makszimilien/Hydrofoil-Control/KiCad/Hydrofoil-Controller/Hydrofoil.kicad_pcb

## KiCad design KiCad/Hydrofoil-Controller/Hydrofoil.kicad_pcb (2024-01-26)

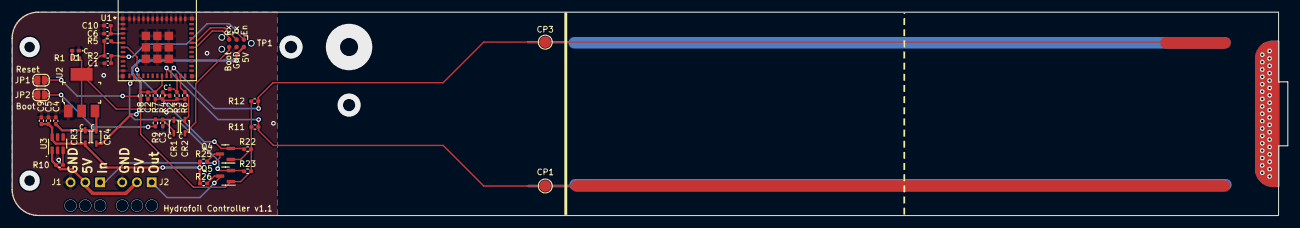
[picture p1: board Hydrofoil.kicad_pcb from above]

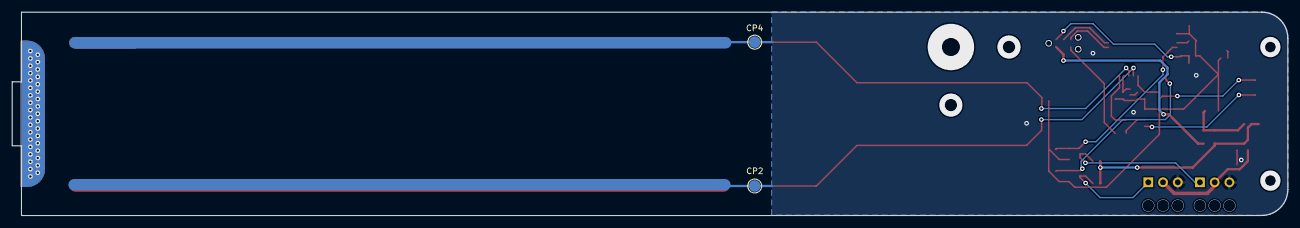
[picture p2: board Hydrofoil.kicad_pcb from below]

Board: 2 copper layers, 219.6 x 35.0 mm, 44 parts (2 on the bottom side), 26 nets.

Parts:
C1, C2, C3: 1u; C_0402_1005Metric_Pad0.74x0.62mm_HandSolder
C4, C5, C6, C9, C10: 10u; C_0402_1005Metric_Pad0.74x0.62mm_HandSolder
CP1, CP2: Long Probe; TestPoint_Pad_D2.0mm
CP3, CP4: Short Probe; TestPoint_Pad_D2.0mm
CR1, CR2, CR3, CR4: CUS08F30_H3F; USC_TOS
D1: Yellow; LED_0402_1005Metric_Pad0.77x0.64mm_HandSolder
D2: Red; LED_0402_1005Metric_Pad0.77x0.64mm_HandSolder
J1, J2: Conn_01x03_Pin; Solder_Connector
JP1: Reset Settings; SolderJumper-2_P1.3mm_Open_RoundedPad1.0x1.5mm
JP2: Boot; SolderJumper-2_P1.3mm_Open_RoundedPad1.0x1.5mm
Q4, Q5: BSS138; SOT-23
R1, R4, R8, R9: 1k; R_0402_1005Metric_Pad0.72x0.64mm_HandSolder
R2, R3, R5, R6, R7, R10, R22, R23, R25, R26: 10k; R_0402_1005Metric_Pad0.72x0.64mm_HandSolder
R11, R12: 1.4M; R_0402_1005Metric_Pad0.72x0.64mm_HandSolder
TP1: Tag-Connect_TC2030-IDC-NL_2x03_P1.27mm_Vertical
U1: ESP32-C3-MINI-1-N4; ESP32-C3-MINI-1_EXP
U2: LD1117S33CTR; SOT-223
U3: TPS22917DBV; SOT-23-6

Connections:
+3.3V: C6.1, C10.1, Q4.1 (G), Q5.1 (G), R1.1, R2.1, R3.1, R4.1, R5.1, R6.1, R7.1, R11.1, R12.1, R22.1, R23.1, U1.3 (3V3), U2.2 (VOUT), U2.4 (VOUT)
+5V: C5.1, C9.1, CR3.2, R25.1, R26.1, U3.6 (VOUT)
+5V-Prog: CR4.2, TP1.2
/+5V-Logic: C4.1, CR3.1, CR4.1, U2.3 (VIN)
/+5V-Raw: J1.2, J2.2, R10.2, U3.1 (VIN)
Cap-Long: CP1.1, R11.2, U1.20 (IO6)
Cap-Ref: CP3.1, R12.2, U1.21 (IO7)
ESP-Boot: CR2.1, TP1.6
ESP-En: C1.1, R2.2, TP1.1, U1.8 (EN)
ESP-Rx: TP1.5, U1.30 (RXD0)
ESP-Tx: TP1.3, U1.31 (TXD0)
GND: C1.2, C2.2, C3.2, C4.2, C5.2, C6.2, C9.2, C10.2, CP2.1, CP4.1, D1.1 (K), J1.3, J2.3, JP1.2 (B), JP2.2 (B), TP1.4, U1.1 (GND), U1.2 (GND), U1.11 (GND), U1.14 (GND), U1.36 (GND), U1.37 (GND), U1.38 (GND), U1.39 (GND), U1.40 (GND), U1.41 (GND), U1.42 (GND), U1.43 (GND), U1.44 (GND), U1.45 (GND), U1.46 (GND), U1.47 (GND), U1.48 (GND), U1.49 (GND), U1.50 (GND), U1.51 (GND), U1.52 (GND), U1.53 (GND), U1.54 (GND), U1.55 (GND), U1.56 (GND), U1.57 (GND), U1.58 (GND), U1.59 (GND), U1.60 (GND), U1.61 (GND), U2.1 (GND), U3.2 (GND)
Input-Boot: CR1.2, CR2.2, R6.2, U1.23 (IO9)
Input-Reset: C2.1, R7.2, R8.1, U1.19 (IO5)
unnamed: C3.1, CR1.1, R9.1
unnamed: D1.2 (A), R1.2
unnamed: D2.2 (A), R4.2
unnamed: JP1.1 (A), R8.2
unnamed: JP2.1 (A), R9.2
unnamed: R5.2, U1.5 (IO2)
unnamed: R10.1, U3.3 (ON)
PWM-In-HV: J1.1, Q4.3 (D), R25.2
PWM-In-LV: Q4.2 (S), R22.2, U1.6 (IO3)
PWM-Out-HV: J2.1, Q5.3 (D), R26.2
PWM-Out-LV: Q5.2 (S), R23.2, U1.13 (IO1)
User-LED: D2.1 (K), R3.2, U1.22 (IO8)
