makszimilien/Hydrofoil-Control/src/filehandling.cpp

#include "SPIFFS.h"
#include "filehandling.h"
#include <Arduino.h>
#include <ArduinoJson.h>

// Variable for JSON document
DynamicJsonDocument jsonDoc(1000);

// Initialize SPIFFS
void initFS() {
  if (!SPIFFS.begin(true)) {
    Serial.println("An error has occurred while mounting SPIFFS");
  } else {
    Serial.println("SPIFFS mounted successfully");
  }
}

// Read JSON File from SPIFFS
String readFileJson(fs::FS &fs, const char *path, const char *property) {
  // Serial.printf("Reading file: %s\r\n", path);

  File file = fs.open(path);
  if (!file || file.isDirectory()) {
    Serial.println("- failed to open file for reading");
    return String();
  }

  size_t size = file.size();
  std::unique_ptr<char[]> buf(new char[size]);

  file.readBytes(buf.get(), size);
  deserializeJson(jsonDoc, buf.get());
  file.close();

  String value = jsonDoc[property];
  return value;
}

// Read JSON File Array from SPIFFS
void readArrayJson(fs::FS &fs, const char *path, const char *property,
                   String *array) {
  // Serial.printf("Reading array from file: %s\r\n", path);

  File file = fs.open(path);
  if (!file || file.isDirectory()) {
    Serial.println("- failed to open file for reading");
  }

  size_t size = file.size();
  std::unique_ptr<char[]> buf(new char[size]);

  file.readBytes(buf.get(), size);
  deserializeJson(jsonDoc, buf.get());
  file.close();
  // JSON array can be longer than string array, fix later !!
  JsonArray macArray = jsonDoc[property];
  // Serial.println("Current element of the array:");
  for (int i = 0; i < macArray.size(); i++) {
    String value = macArray[i].as<String>();
    array[i] = value;
    if (value != "") {
      // Serial.println(value);
    }
  }
}

// Write JSON file to SPIFFS
void writeFileJson(fs::FS &fs, const char *path, const char *property,
                   const char *value) {
  // Serial.printf("Writing file: %s\r\n", path);

  // Read current content
  File file = fs.open(path);
  if (!file || file.isDirectory()) {
    Serial.println("- failed to open file for reading");
    return;
  }

  size_t size = file.size();
  std::unique_ptr<char[]> buf(new char[size]);

  file.readBytes(buf.get(), size);
  deserializeJson(jsonDoc, buf.get());
  file.close();

  // Expand current content and write to file
  file = fs.open(path, FILE_WRITE);
  if (!file) {
    Serial.println("- failed to open file for writing");
    return;
  }

  // Creating JSON record
  jsonDoc[property] = value;
  // Writing data to JSON file
  serializeJson(jsonDoc, file);
  file.close();
}

// Write JSON file Array to SPIFFS
void writeArrayJson(fs::FS &fs, const char *path, const char *property,
                    String *array, int size) {
  // Serial.printf("Writing array to file: %s\r\n", path);

  File file = fs.open(path, FILE_WRITE);
  if (!file) {
    Serial.println("- failed to open file for writing");
    return;
  }

  JsonArray arrayToJson = jsonDoc.createNestedArray(property);
  for (int i = 0; i < size; i++) {
    String value = array[i];
    arrayToJson.add(value);
    // if (value != "")
    // Serial.println(value);
  }
  // Writing data to JSON file
  serializeJson(jsonDoc, file);
  file.close();
}
