makszimilien/Hydrofoil-Control/(commit log)

2023-08-18 Add PID (not working)
    [main.cpp]
2023-08-19 Use PID for servo control
2023-08-21 Add external control using PWM input
2023-08-22 Add pulseIn timeout to reduce cycle time, fix setpoint value definition
    [main.cpp]
2023-08-27 Use external ADC
2023-08-27 Use extarnal ADC, remove commented lines
2023-08-31 Add external ADC (ADS1115), read from A0 and A1
2023-09-01 Use 2 chs on the ADC
2023-09-02 Calculate sensorRatio
2023-09-02 Use sensor for servo control
2023-09-07 Add KiCad files
    [Hydrofoil.kicad_pcb, Hydrofoil.kicad_sch, mast.dxf]
2023-09-07 Start routing on the PCB
    [Hydrofoil.kicad_pcb]
2023-09-10 Finalize edgecut, device arrangement, wiring
    [Hydrofoil.kicad_pcb, Hydrofoil.kicad_sch, mast.dxf]
2023-09-10 Add probe-traces
    [Hydrofoil.kicad_pcb]
2023-09-14 Initialize codebase for ESP32
2023-09-15 Fix handling Slave input
    [main.cpp]
2023-09-19 Remove ArduinoOTA, add mDNS
2023-09-21 Fix storing and reclaiming slider value
    [main.cpp]
2023-09-22 Fix JSON array write issue
    [filehandling.cpp, main.cpp]
2023-09-23 Show added devices on control page
2023-09-23 Add ESP-NOW funcionality (receiver does not work), convert strings to bool
    [main.cpp]
2023-09-25 Fix ESP-NOW master send issue
    [main.cpp]
2023-09-25 User user input MAC for adding slave device
2023-09-29 Fix writing JSON array to SPIFFS
    [filehandling.cpp, filehandling.h, main.cpp]
2023-10-06 Add PS to the curcuit, change PCB outline
    [ADS1115-ADC.kicad_sch, ESP32-C3-MINI-1-N4.kicad_sch, Hydrofoil.kicad_pcb, Hydrofoil.kicad_sch, untitled.kicad_sch]
2023-10-07 Add ESP32-C3-Mini
    [ESP32-C3-MINI-1-N4.kicad_sch, Hydrofoil.kicad_sch]
2023-10-07 Add level shifters
    [ADS1115-ADC.kicad_sch, ESP32-C3-MINI-1-N4.kicad_sch, Hydrofoil.kicad_pcb, Hydrofoil.kicad_sch]
2023-10-08 Change resistor values
    [ADS1115-ADC.kicad_sch, ESP32-C3-MINI-1-N4.kicad_sch, Hydrofoil.kicad_pcb, Hydrofoil.kicad_sch, untitled.kicad_sch]
2023-10-08 Change reverse polarity protection, start the PCB design
    [ADS1115-ADC.kicad_sch, ESP32-C3-MINI-1-N4.kicad_sch, Hydrofoil.csv, Hydrofoil.kicad_pcb, Hydrofoil.kicad_sch]
2023-10-13 Use load switch, fix TC2030 pins, fix strapping pins
    [ADS1115-ADC.kicad_sch, ESP32-C3-MINI-1-N4.kicad_sch, Hydrofoil.kicad_sch]
2023-10-13 Organize parts on the PCB
    [ADS1115-ADC.kicad_sch, ESP32-C3-MINI-1-N4.kicad_sch, Hydrofoil.kicad_pcb, Hydrofoil.kicad_sch]
2023-10-15 Finish PCB layout, start PCB routing
    [ADS1115-ADC.kicad_sch, Hydrofoil.kicad_pcb, Hydrofoil.kicad_sch]
2023-10-18 Finish routing
    [Hydrofoil.kicad_pcb]
2023-10-18 Generate fabrication files
    [Hydrofoil-B_Cu.gbr, Hydrofoil-B_Fab.gbr, Hydrofoil-B_Mask.gbr, Hydrofoil-B_Paste.gbr, Hydrofoil-B_Silkscreen.gbr, Hydrofoil-Edge_Cuts.gbr, Hydrofoil-F_Cu.gbr, Hydrofoil-F_Fab.gbr]
2023-10-21 Add MPN to BOM, create PCBWay specific fabrication files
    [BOM_Hydrofoil.kicad_pcb.xls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]
2023-10-29 Make sendEspNow function failsafe
    [main.cpp]
2023-11-02 Add device reset functionality
    [filehandling.cpp, main.cpp]
2023-11-03 Change reset times, set all parameters to default when resetting device
    [filehandling.cpp, main.cpp]
2023-11-03 Use float variables for PID parameters, set input ranges
2023-11-06 Fix LED's PNs
    [ADS1115-ADC.kicad_sch, ESP32-C3-MINI-1-N4.kicad_sch, Hydrofoil.kicad_sch]
2023-11-11 Add external ADC, read values on 2 channels
2023-11-11 Read PWM input from receiver
2023-11-11 Use interrupt instead of pulseIn to reduce cycle time
2023-11-24 Change environment to ESP32-C3
2023-11-25 Fix I2C issues, fix device reset
    [main.cpp]
2023-12-01 Widen servo traces, add C to slikscreen, replace LEDs to 0402
    [ADS1115-ADC.kicad_sch, ESP32-C3-MINI-1-N4.kicad_sch, Hydrofoil.kicad_pcb, Hydrofoil.kicad_sch]
2023-12-01 Add missing silkscreen texts
    [ADS1115-ADC.kicad_sch, BOM_Hydrofoil.kicad_pcb.xls, Hydrofoil.kicad_pcb]
2023-12-02 Fix ADC reading issue
    [main.cpp]
2023-12-11 Calculate ratio from sensor readings
2023-12-19 Add capacitive sensor, organize KiCad folder
    [ADS1115-ADC.kicad_sch, BOM_Hydrofoil.kicad_pcb.xls, Capacitive-Sensor.kicad_pcb, Capacitive-Sensor.kicad_sch, ESP32-C3-MINI-1-N4.kicad_sch, Hydrofoil.kicad_pcb, Hydrofoil.kicad_sch]
2023-12-19 Fix sensor debug serial messages
    [main.cpp]
2024-01-20 Remove ADC, add capacitance measurement
2024-01-20 Use interrupt for measurement, delete sensor pcb
    [Capacitive-Sensor.kicad_pcb, Capacitive-Sensor.kicad_sch]
2024-01-23 Remove ADC from PCB
    [ADS1115-ADC.kicad_sch, ESP32-C3-MINI-1-N4.kicad_sch, Hydrofoil.kicad_pcb, Hydrofoil.kicad_sch]
2024-01-26 Add capacitance measurement to the PCB
    [BOM_Hydrofoil.kicad_pcb.xls, ESP32-C3-MINI-1-N4.kicad_sch, Hydrofoil.kicad_pcb, Hydrofoil.kicad_sch]
2024-02-03 Fix the listing of the slave devices on the UI
    [main.cpp]
2024-02-04 Implement PID controller
2024-02-04 Fix PID parameter issues
    [main.cpp]
2024-02-04 Implement PWM signal input, modify setpoint based on reading
2024-02-04 Fix servo output issues
    [main.cpp]
2024-02-05 Calculate control value in the PWM In interrupt
2024-03-02 Update PID tunings when parameters changed
2024-03-02 Fix setting min and max values on the measurement scale
    [main.cpp]
2024-03-03 Fix non-blocking delay, set measuring freq. to 200 Hz
    [main.cpp]
2024-03-15 Remove WS, use HTTP GET for sliders, implement PID enable functionality
2024-03-15 Debounce slider events, comment out Serial.print calls
2024-03-17 Remove servoMid param, center servo when PID disabled
2024-03-17 Fix servo min & max handling on slave devices
    [main.cpp]
2024-03-17 Send MAC addresses via HTTP_GET, blink the LED when resetting device
    [main.cpp]
2024-03-17 Display slave device's MAC addresses on the page
2024-03-23 Add PWM input effect slider and functionality
2024-03-23 Fix storing servoPos, set tickers properly
    [main.cpp]
2024-04-25 Use busy loop insted of interrupt to finish cap measurement
2024-05-20 Reduce measurement and PID calculation time
2024-06-16 Use us instead of degree for servo control
2024-06-18 Change PID mode, change default reset values, remove logger the functions, fix sending servo params to the page
    [main.cpp]
2024-06-25 Put back serial logger, use fixed values for min- and maxMeasured
    [main.cpp]
2024-06-25 Use one ticker for calculating position and PID
2024-06-29 Improve upon adding new slave device
2024-06-30 Use MAC address for unique SSID, use fixed channel, fix wifimanager css
    [main.cpp]
2024-06-30 Fix PWM input issue
    [main.cpp]
